tperrierrr/UCR-BatteryCharger-SeniorDesign-2019-20/(commit log)

2020-03-16 Add files via upload
    This is the code and files for the website control of the Arduino.
2020-03-16 Add files via upload
    This is the Arduino code for controlling the digipot.
